AlanBejnarowicz/CycBot/README.md

# CycBot

A Soft Robot for Non-verbal Communication in Human-Robot interaction
Screenshot from 2025-12-09 10-40-44
