AlanBejnarowicz/CycBot/report/main.tex

% \documentclass[letterpaper, 10pt, conference]{ieeeconf}  % Comment this line out if you need a4paper

\documentclass[a4paper, 10pt, conference]{ieeeconf}      % Use this line for a4 paper

\IEEEoverridecommandlockouts                              % This command is only needed if 
                                                          % you want to use the \thanks command

\overrideIEEEmargins                                      % Needed to meet printer requirements.

% The following packages can be found on http:\\www.ctan.org
% \usepackage{graphics} % for pdf, bitmapped graphics files
%\usepackage{epsfig} % for postscript graphics files
%\usepackage{mathptmx} % assumes new font selection scheme installed
%\usepackage{times} % assumes new font selection scheme installed
%\usepackage{amsmath} % assumes amsmath package installed
%\usepackage{amssymb}  % assumes amsmath package installed
\usepackage{graphicx}
\usepackage{subcaption}

\usepackage{hyperref}
\hypersetup{
    colorlinks=true,
    linkcolor=black,
    filecolor=magenta,
    urlcolor=blue,
    citecolor=blue,
    pdfpagemode=UseOutlines
}
\urlstyle{same}

\usepackage[backend=biber,style=ieee]{biblatex}
\addbibresource{references.bib}

\title{\LARGE \bf{CycBot: A~Cyclical Soft Robot for~Non-verbal Communication with~Humans}}

\begin{document}

\author{Alan Bejnarowicz$^{1}$, Jan Górski$^{2}$ and Maciej Piszczek$^{3}$% <-this % stops a space
\thanks{$^{1}${\tt\small albej24@student.sdu.dk}}%
\thanks{$^{2}${\tt\small jagor24@student.sdu.dk}}%
\thanks{$^{3}${\tt\small mapis24@student.sdu.dk}}%
}

\maketitle
\thispagestyle{empty}
\pagestyle{empty}

%%%%%%%%%%%%%%%%%%%%%%%%%%%%%%%%%%%%%%%%%%%%%%%%%%%%%%%%%%%%%%%%%%%%%%%%%%%%%%%%
\begin{abstract}

In this project, we present CycBot --- a~soft robot designed for non-verbal communication with humans. The~robot's design incorporates silicone materials and 3D~printing. Our robot was inspired by~toys like Furbies~\cite{furby} and Tamagotchis~\cite{tamagotchi}, aiming to create an~engaging interaction experience. We~achieved a~successful design and fabrication of CycBot, demonstrating its ability to~express emotions using soft robotics actuator. In~our Human-Robot Interaction~(HRI) experiment, we evaluated the~robot's effectiveness in~conveying emotions and engaging users.

\end{abstract}

%%%%%%%%%%%%%%%%%%%%%%%%%%%%%%%%%%%%%%%%%%%%%%%%%%%%%%%%%%%%%%%%%%%%%%%%%%%%%%%%
\input{sections/introduction.tex}

\input{sections/methods.tex}

\input{sections/results.tex}

\input{sections/discussion.tex}

\input{sections/conclusion.tex}

\addtolength{\textheight}{-12cm}   % This command serves to balance the column lengths

%%%%%%%%%%%%%%%%%%%%%%%%%
\input{sections/appendix.tex}

\printbibliography[title={References}]

\end{document}
