AlanBejnarowicz/CycBot/report/sections/appendix.tex

\section*{Appendix}
% Insert the link to an edited video (unlisted YouTube) of your project and a brief description of supplementary materials (code, properly labelled data, etc.). State each student's contribution to the project and report according to the provided template on ItsLearning.

\subsection*{YouTube video}

\par The~video demonstration of this project can be found on~\href{https://youtu.be/WA5S0skLYgE?si=YtxchnAxc7C28FYE}{YouTube}.

\subsection*{Code}

\par The~code used in this project can be found on~\href{https://github.com/AlanBejnarowicz/CycBot}{GitHub}.

\subsection*{Survey}

\par The~survey used in the~HRI experiment can be found on~\href{https://www.survey-xact.dk/LinkCollector?key=4DSJ6MZQJ112}{SurveyXact}.

\subsection*{Contributions}

\begin{enumerate}
    \item Conceptual contributions (Alan 40\%, Jan 20\%, Maciej 40\%)
    \item Writing/implementation of control code (Alan 40\%, Jan 40\%, Maciej 20\%)
    \item Design and manufacturing (Alan 30\%, Jan 30\%, Maciej 40\%)
    \item Production of experimental data (Alan 25\%, Jan 50\%, Maciej 25\%)
    \item Analysis and presentation of experimental data (Alan 35\%, Jan 35\%, Maciej 30\%)
    \item Writing report (Alan 35\%, Jan 35\%, Maciej 30\%)
\end{enumerate}
