AlanBejnarowicz/CycBot/report/data/cyc_bot_render.png

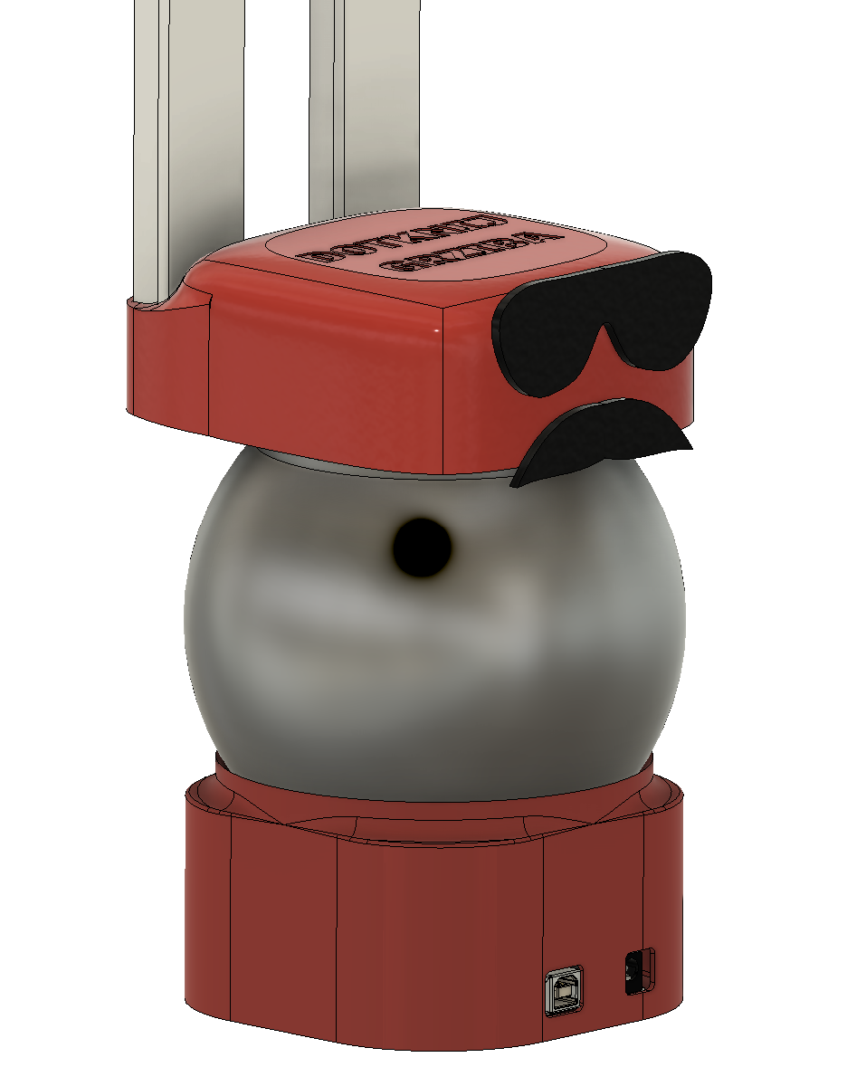
report/data/cyc_bot_render.png
