AlanBejnarowicz/CycBot/report/report_template_Latex/figure_1.jpg

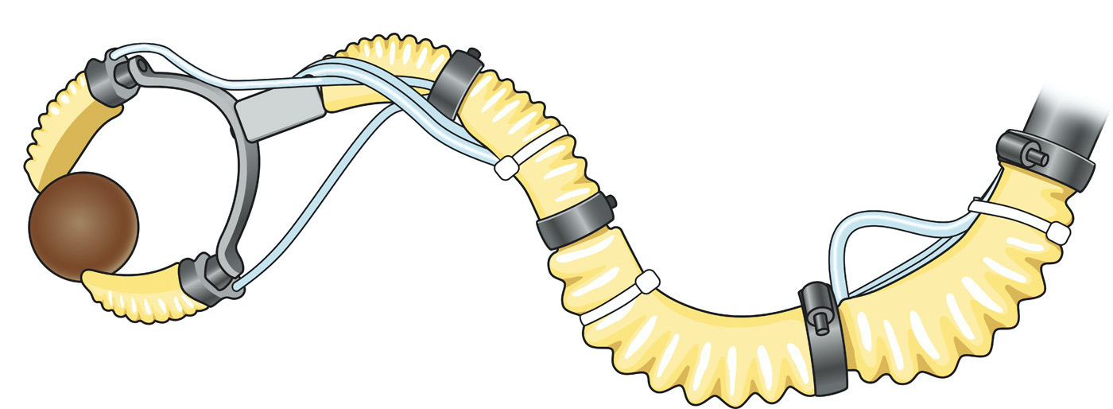
report/report_template_Latex/figure_1.jpg
