AlanBejnarowicz/CycBot/report/sections/results.tex

\section{Results} % (~40%)
% The results section of your report should contain the actual results. No interpretations, no extrapolations, just the (processed) data. Displayed nicely with confidence limits included in some form - error bars, standard deviations, whatever. The description of how you processed your data should be included in either the methods or else the results section. Note that unexpected and outlying results should also be included, especially if they are repeatable. In theory, negative results are just as important as positive results. It is just as scientifically valid and useful to state that this approach to this problem doesn't work, as it is to find an approach that does work. As the project focuses on nonverbal communication in interactions with humans, you should include results of one or more human-robot interaction (HRI) experiments evaluating this communication and demographic data for participants (age, gender, prior robot interaction experience).

\par The~collected data is summarized in Table~\ref{tab:hri-data} and in Figure~\ref{fig:hri-data}. The~average scores for~each emotion are presented in Table~\ref{tab:average-hri-data}.

\begin{table}[!ht]
    \caption{HRI experiment results.}\label{tab:hri-data}
    \begin{center}
        \begin{tabular}{cccccc}
            \hline
            Emotion & Very Poor & Poor & Acceptable & Good & Very Good \\
            \hline
            Sad & 5\% & 18\% & 41\% & 27\% & 19\% \\
            Interested & 18\% & 36\% & 27\% & 14\% & 5\% \\
            Happy & 18\% & 32\% & 14\% & 27\% & 9\% \\
            Annoyed & 27\% & 23\% & 23\% & 23\% & 5\% \\
            \hline
        \end{tabular}
    \end{center}
\end{table}

\begin{table}[!ht]
    \caption{Average results.}\label{tab:average-hri-data}
    \begin{center}
        \begin{tabular}{cc}
            \hline
            Emotion & Average Score \\
            \hline
            Sad & 3.2 \\
            Interested & 2.5 \\
            Happy & 2.8 \\
            Annoyed & 2.5 \\
            \hline
        \end{tabular}
    \end{center}
\end{table}

\begin{figure}[!ht]
    \centering
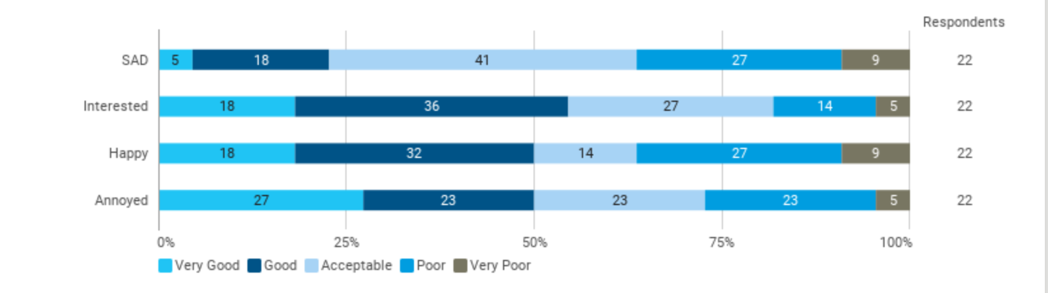
[picture p12: report/data/main_poll.png]
    
    \caption{HRI experiment results visualization.}\label{fig:hri-data}
\end{figure}

\par Additional demographic data of~the~participants is presented in Figure~\ref{fig:age-data}, Figure~\ref{fig:gender-data} and Figure~\ref{fig:previous-experience-data}.

\begin{figure}[!ht]
    \centering
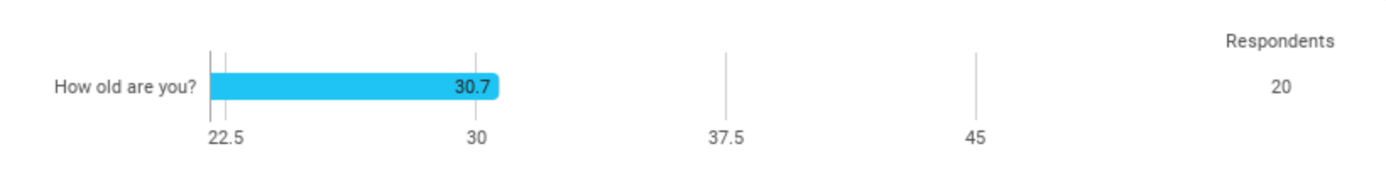
[picture p13: report/data/Age_poll.png]
    
    \caption{Age distribution of~the~participants.}\label{fig:age-data}
\end{figure}

\begin{figure}[!ht]
    \centering
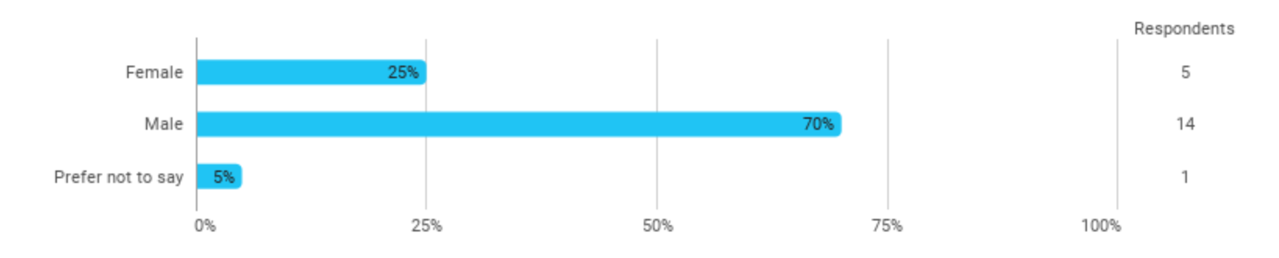
[picture p14: report/data/gender_poll.png]
    
    \caption{Gender distribution of~the~participants.}\label{fig:gender-data}
\end{figure}

\begin{figure}[!ht]
    \centering
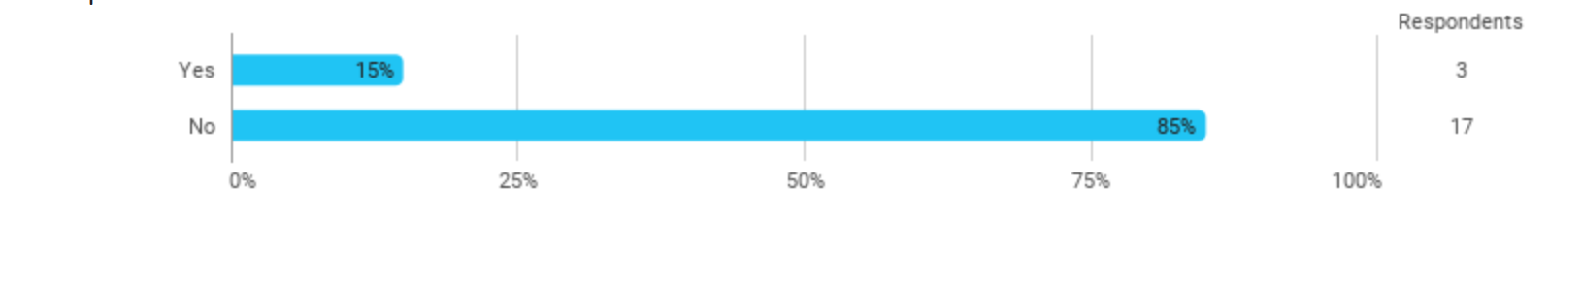
[picture p15: report/data/interactions_poll.png]
    
    \caption{Previous robot interaction experience distribution of~the~participants.}\label{fig:previous-experience-data}
\end{figure}
